ttteo15/Project-Devices-and-Electronic-Circuits/Schematics/schema.jpg

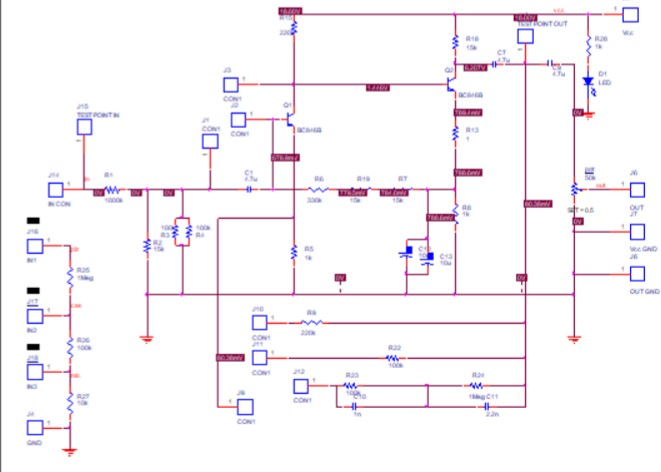
Schematics/schema.jpg
