ttteo15/Project-Devices-and-Electronic-Circuits/Schematics/pai-PSpiceFiles/SCHEMATIC1/psf/psf.cir

** Profile: "SCHEMATIC1-psf"  [ C:\Users\TEO\Desktop\P1_2023_432A_Nume_Prenume_PAI_N24_OrCAD\Schematics\pai-pspicefiles\schematic1\psf.sim ] 

** Creating circuit file "psf.cir" 
** WARNING: THIS AUTOMATICALLY GENERATED FILE MAY BE OVERWRITTEN BY SUBSEQUENT SIMULATIONS

*Libraries: 
* Profile Libraries :
* Local Libraries :
* From [PSPICE NETLIST] section of C:\SPB_Data\cdssetup\OrCAD_PSpice\17.2.0\PSpice.ini file:
.lib "nomd.lib" 

*Analysis directives: 
.OPTIONS ADVCONV
.PROBE64 V(alias(*)) I(alias(*)) W(alias(*)) D(alias(*)) NOISE(alias(*)) 
.INC "..\SCHEMATIC1.net" 


.END
