ttteo15/Project-Devices-and-Electronic-Circuits/(list of files, drawings)

Other design files:
Schematics/pai.opj
Schematics/pai_docs/PAI.DSN
Schematics/TEO_PCB.DSN
